akita11/SolenoidStrokeMeasureControl/work/test240513/graph.jpg

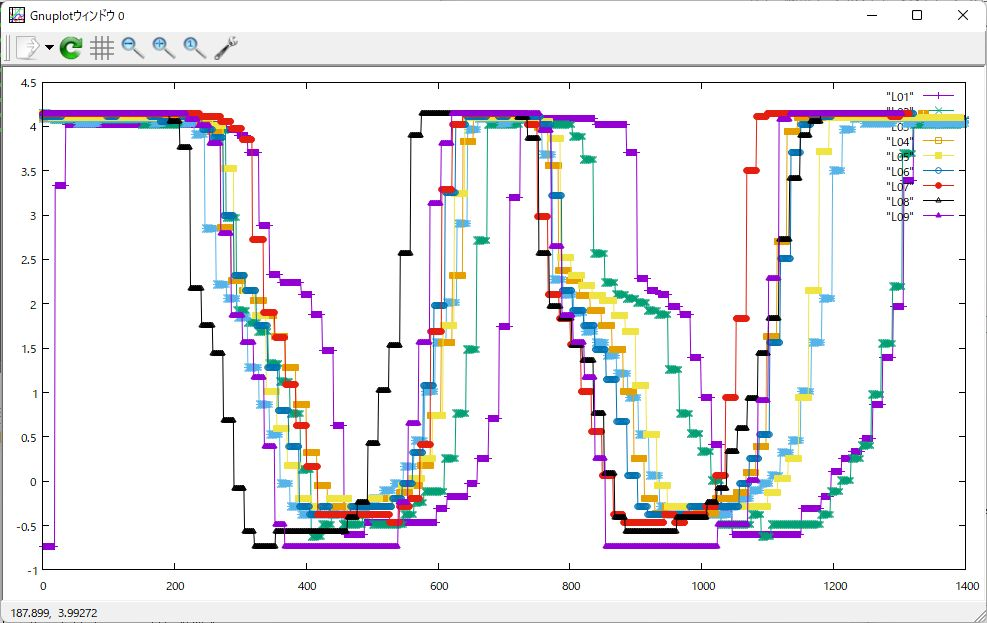
work/test240513/graph.jpg
