akita11/SolenoidStrokeMeasureControl/work/ESP32_Standalone/README.md

M5.update()などでけっこうADCのタイミングがばらつく。マルチコアをうまく使えば解消できるかもしれないが、現時点では十分に解消できていないので、いったん保留(240720:akita11)
