akita11/SolenoidStrokeMeasureControl/work/LTspice/Tlong_I.png

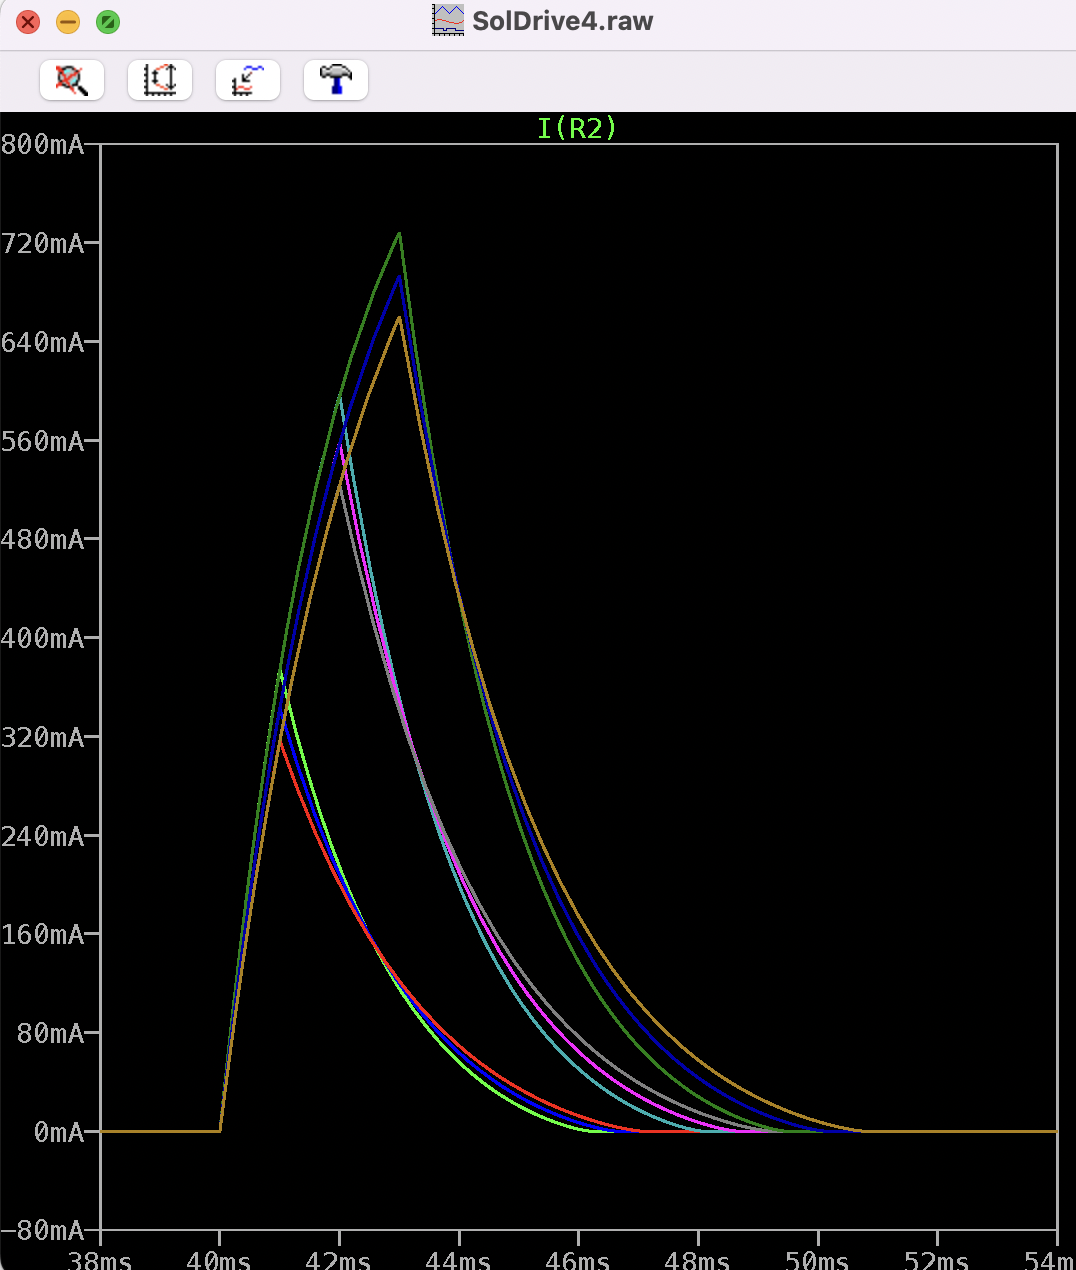
work/LTspice/Tlong_I.png
