akita11/SolenoidStrokeMeasureControl/work/LTspice/Tlong_V.png

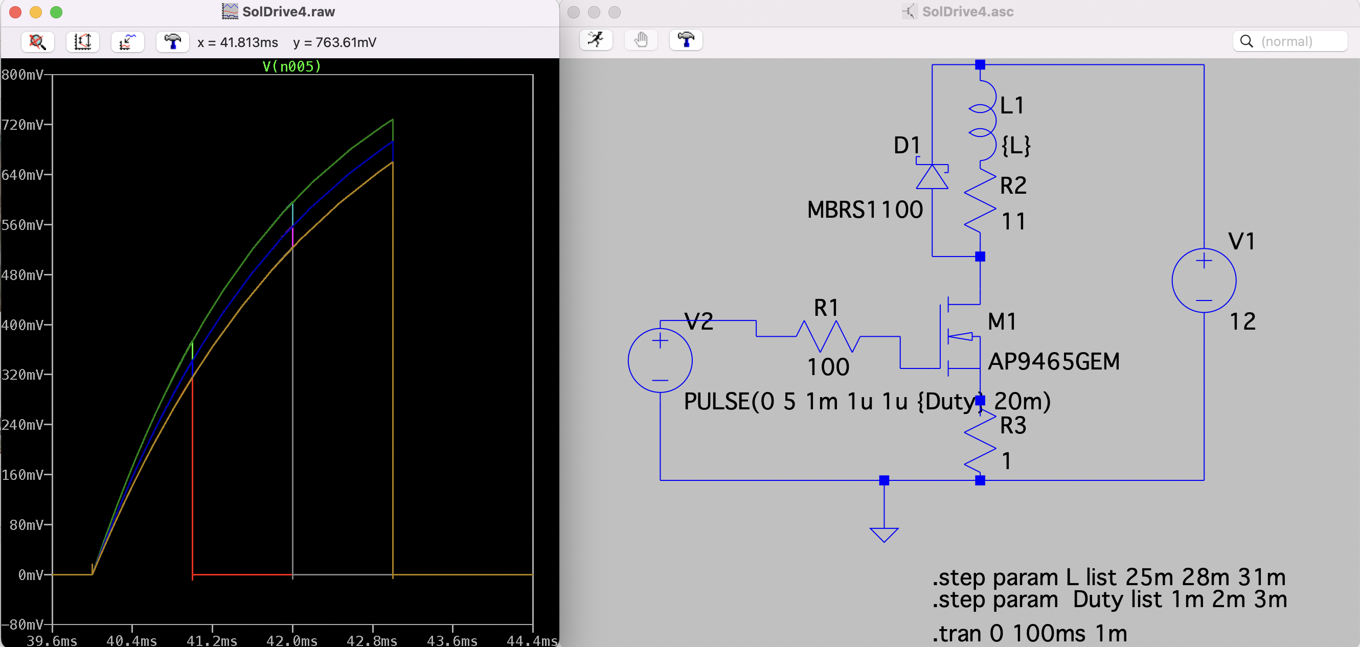
work/LTspice/Tlong_V.png
