akita11/SolenoidStrokeMeasureControl/work/LTspice/Tlong_V_IdealD.png

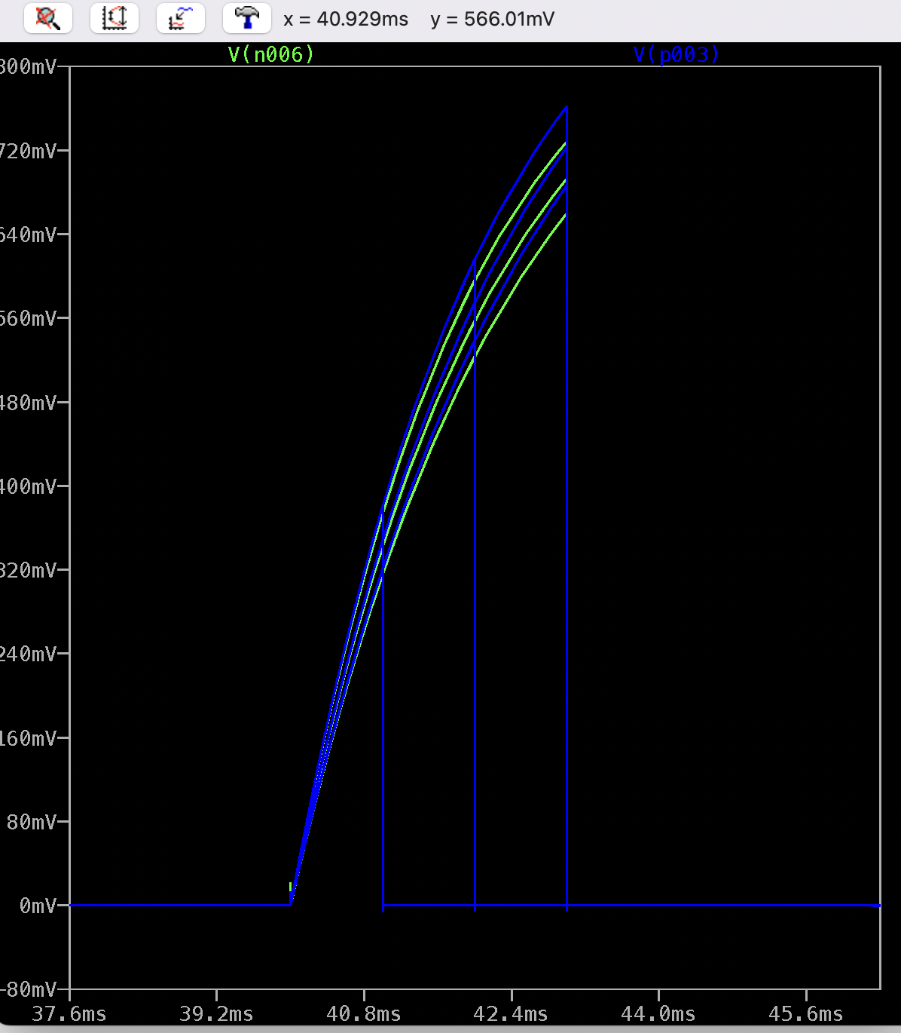
work/LTspice/Tlong_V_IdealD.png
