akita11/SolenoidStrokeMeasureControl/work/LTspice/Tshort_I.png

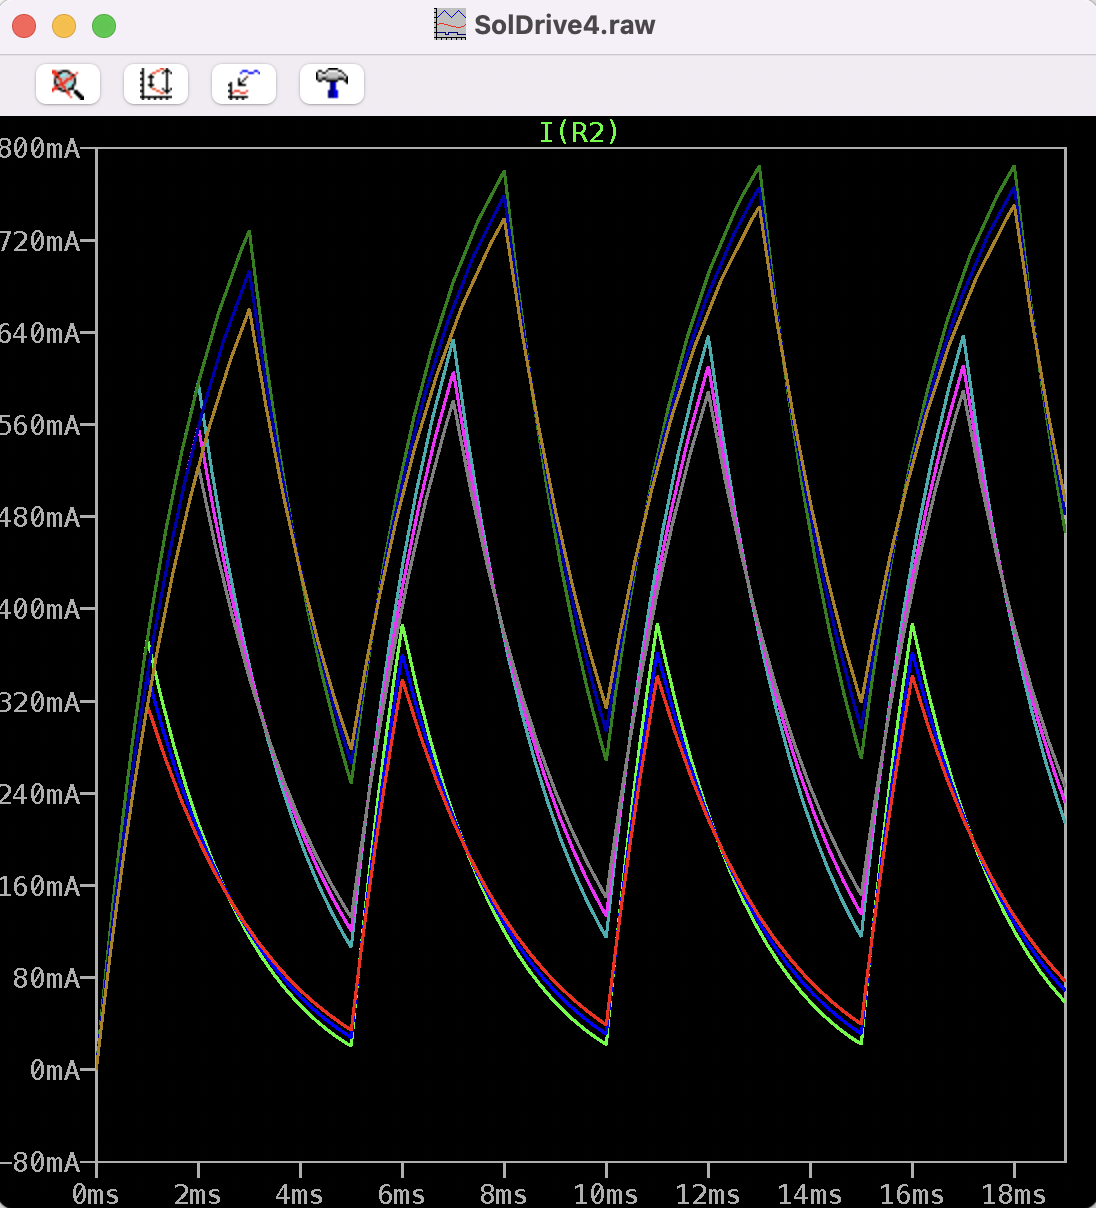
work/LTspice/Tshort_I.png
