akita11/SolenoidStrokeMeasureControl/work/LTspice/Tshort_V.png

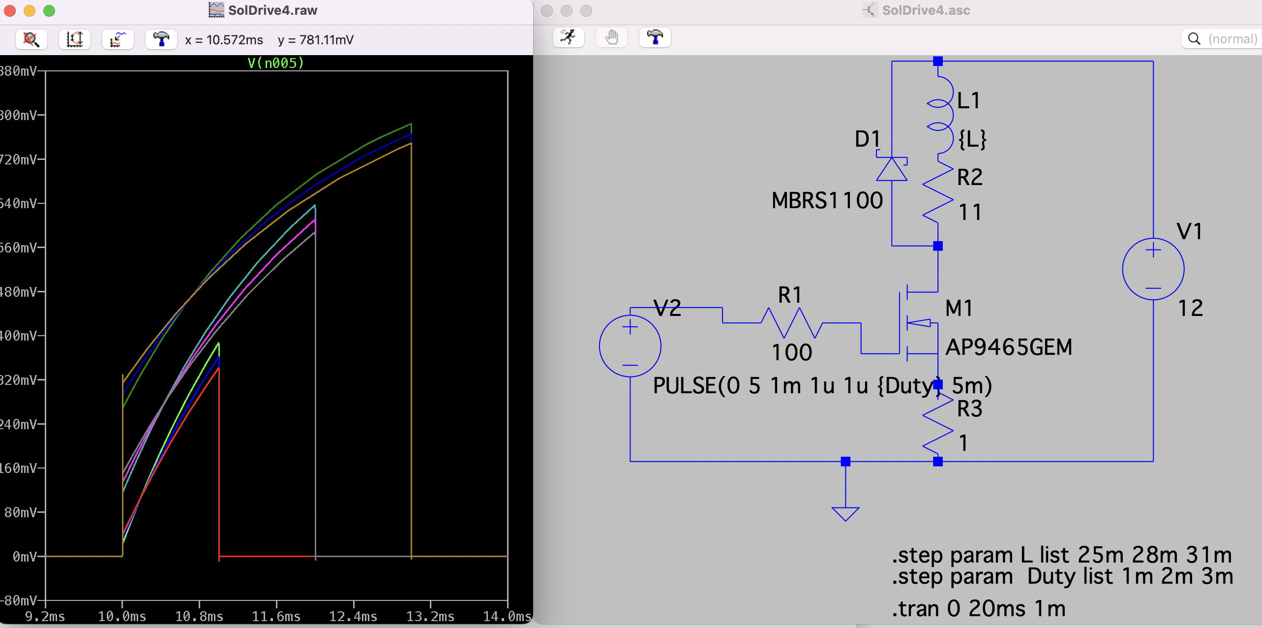
work/LTspice/Tshort_V.png
