akita11/SolenoidStrokeMeasureControl/work/LTspice/Tshort_V_IdealD.png

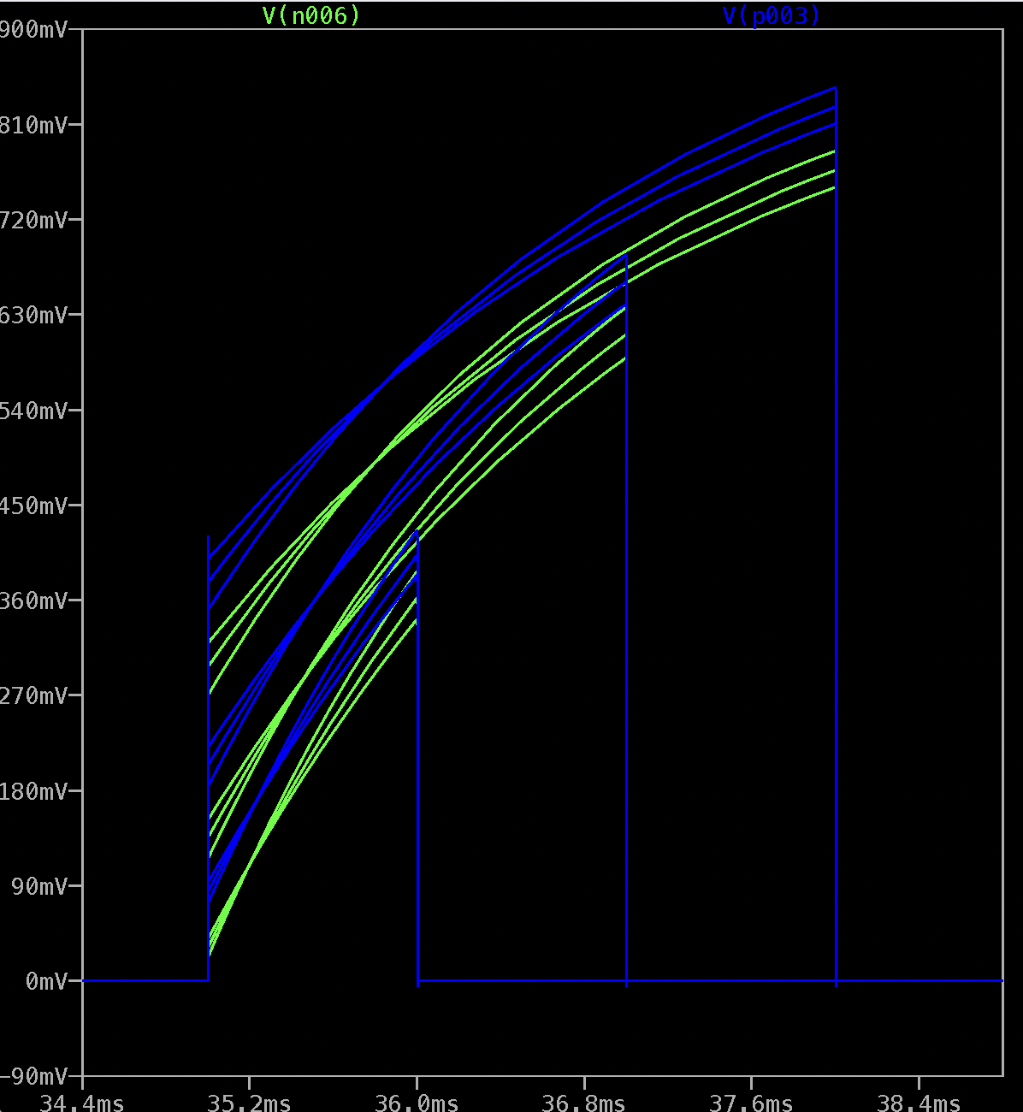
work/LTspice/Tshort_V_IdealD.png
