akita11/SolenoidStrokeMeasureControl/work/LTspice/V_0.png

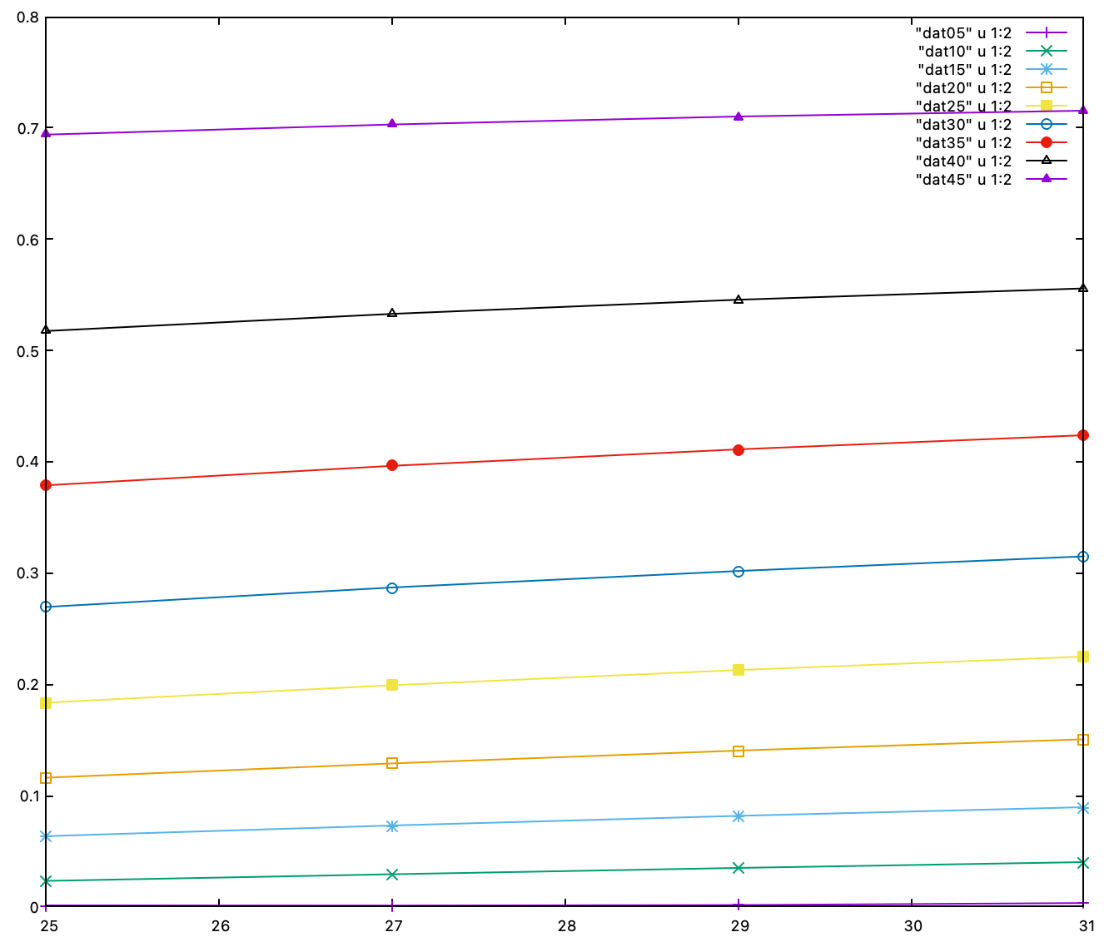
work/LTspice/V_0.png
