akita11/SolenoidStrokeMeasureControl/work/LTspice/V_05-0.png

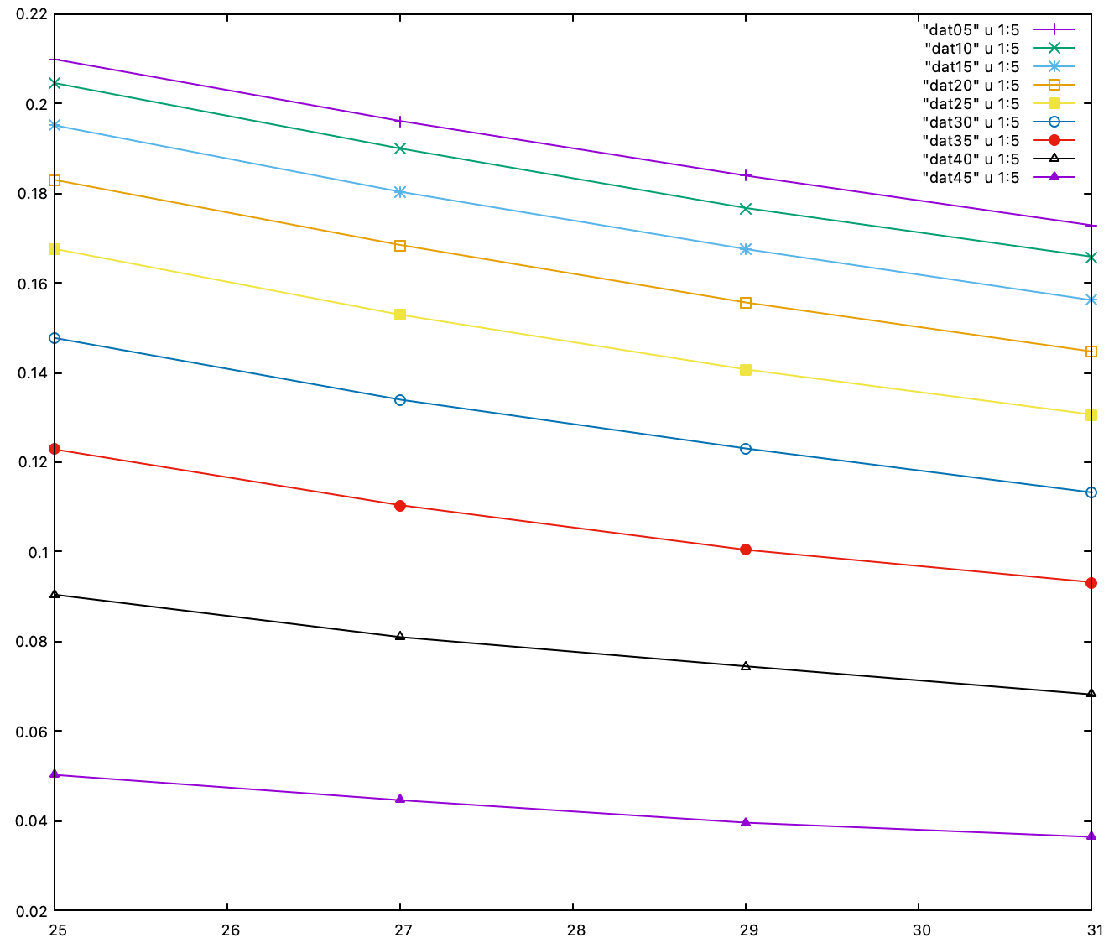
work/LTspice/V_05-0.png
