akita11/SolenoidStrokeMeasureControl/work/LTspice/V_05.png

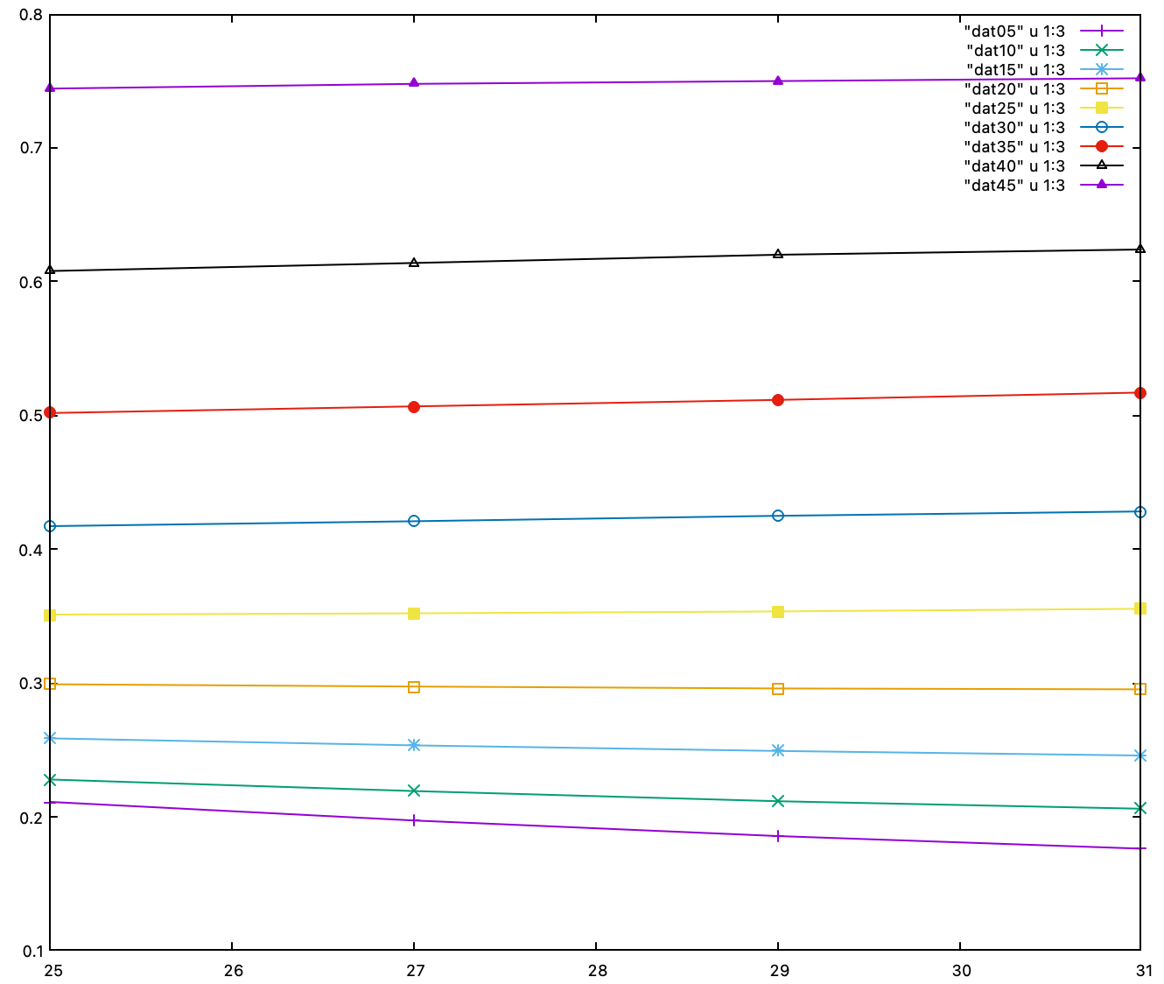
work/LTspice/V_05.png
