akita11/SolenoidStrokeMeasureControl/work/LTspice/V_10-05.png

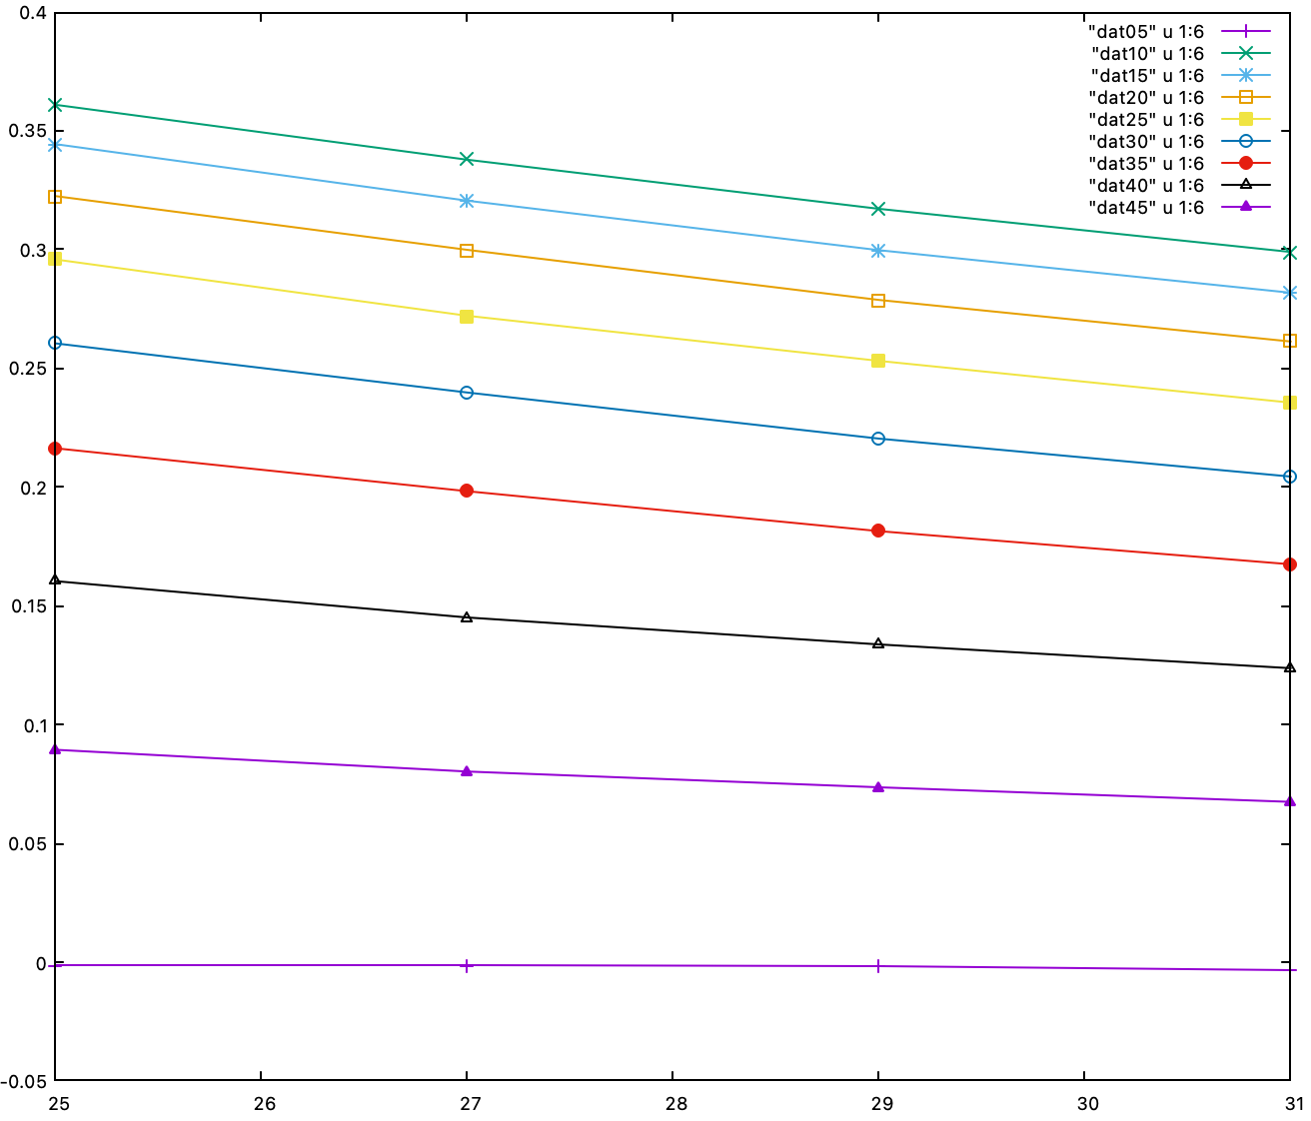
work/LTspice/V_10-05.png
