akita11/SolenoidStrokeMeasureControl/work/LTspice/V_10.png

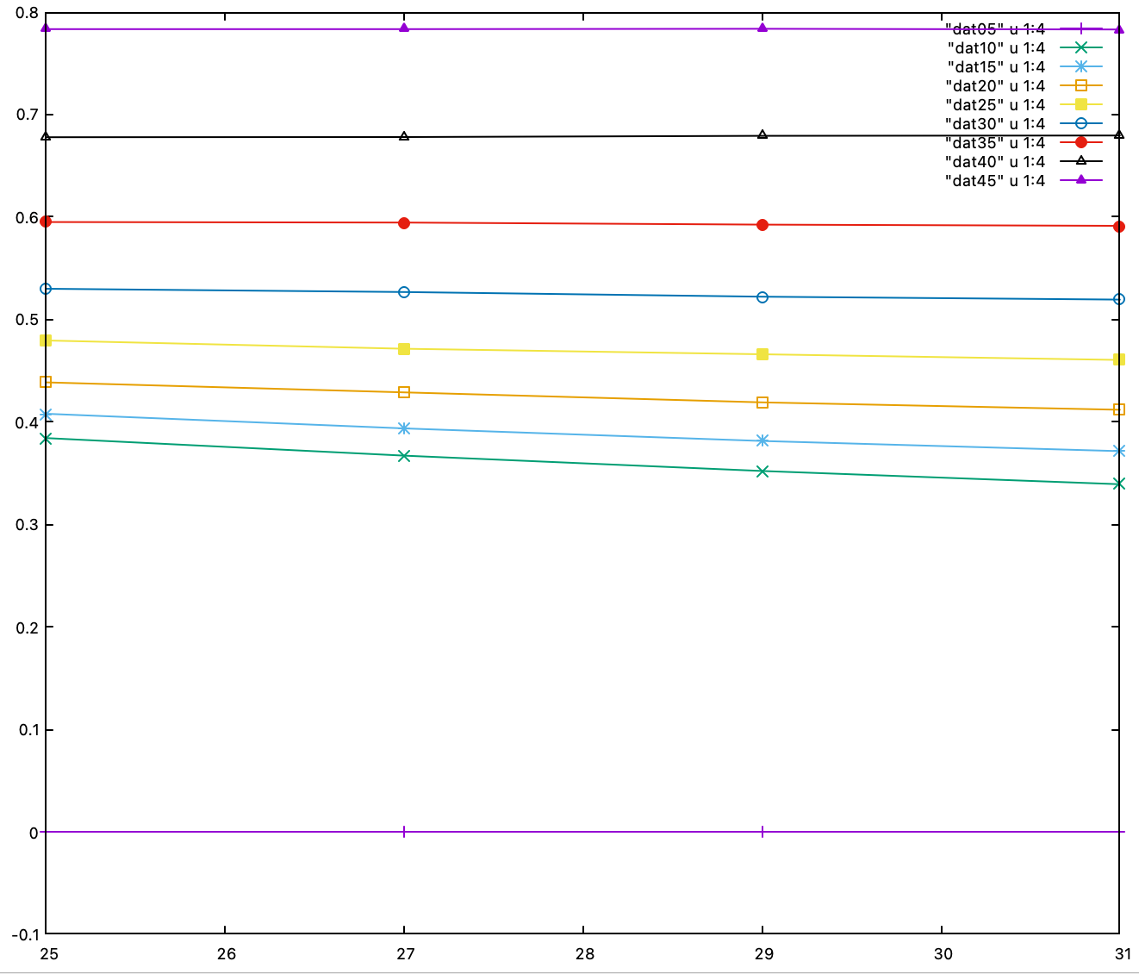
work/LTspice/V_10.png
