akita11/SolenoidStrokeMeasureControl/work/Measure_vs_Calc/SolStrokeExp.xlsx

Sheet: 240508
Rs= | 65.8
PWM Cycle=10ms
 |  |  | ADC[10bit] |  |  | V[V] |  |  | I(=V/Rs)[A]
Stroke | L[mH] | PWM ON[ms] | 50us | 100us | 500us | 50us | 100us | 500us | 50us | 100us | 500us | Ton | 500us-50us | 500us-100us
Neutral | 20.48 | 1 | 150 | 179 | 327 | 0.732421875 | 0.8740234375 | 1.596679688 | 0.03625850866 | 0.043268487 | 0.07904354889 | 1 | 0.04278504022 | 0.03577506188
Neutral | 20.48 | 2 | 148 | 176 | 324 | 0.72265625 | 0.859375 | 1.58203125 | 0.03577506188 | 0.04254331683 | 0.07831837871 | 2 | 0.04254331683 | 0.03577506188
Neutral | 20.48 | 3 | 147 | 175 | 321 | 0.7177734375 | 0.8544921875 | 1.567382812 | 0.03553333849 | 0.04230159344 | 0.07759320854 | 3 | 0.04205987005 | 0.0352916151
Neutral | 20.48 | 4 | 147 | 175 | 319 | 0.7177734375 | 0.8544921875 | 1.557617188 | 0.03553333849 | 0.04230159344 | 0.07710976176 | 4 | 0.04157642327 | 0.03480816832
Neutral | 20.48 | 5 | 149 | 177 | 320 | 0.7275390625 | 0.8642578125 | 1.5625 | 0.03601678527 | 0.04278504022 | 0.07735148515 | 5 | 0.04133469988 | 0.03456644493
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
