akita11/SolenoidStrokeMeasureControl/work/LTspice/IdealD.asc

D1: schottky; MBRS1100
D2: diode; Dideal
V1: voltage; 0
Named nets: 0
.dc v1 0 2 0.01
.model Dideal D(Ron=0.009 Roff=1MEG Vfwd=0.8 epsilon=1m revepsilon =1m)
