akita11/SolenoidStrokeMeasureControl/work/LTspice/SolDrive.asc

D1: schottky; MBRS1100
L1: ind; {L}; Rser=1
M1: nmos; AP9465GEM
R1: Res; 100
R2: Res; 10
V1: voltage; 12
V2: voltage; PULSE(0 5 0.5m 1u 1u 5m 10m)
Named nets: 0
.tran 0 50ms 1m
.step param L list 10m 12m 15m
