akita11/SolenoidStrokeMeasureControl/work/LTspice/SolDrive2.asc

D1: schottky; MBRS1100
L1: ind; {L}; Rser=1
M1: nmos; AP9465GEM
R1: Res; 100
R2: Res; 11
V1: voltage; 12
V2: voltage; PULSE(0 5 1m 1u 1u 50m 100m)
Named nets: 0
.tran 0 200ms 1m
.step param L list 25m 28m 31m
