akita11/SolenoidStrokeMeasureControl/work/LTspice/SolDrive4.asc

D1: schottky; MBRS1100
L1: ind; {L}; Rser=1
M1: nmos; AP9465GEM
R1: Res; 100
R2: Res; 11
R3: Res; 1
V1: voltage; 12
V2: voltage; PULSE(0 5 1m 1u 1u {Duty} 20m)
Named nets: 0
.tran 0 100ms 1m
.step param L list 25m 28m 31m
.step param  Duty list 1m 2m 3m
