akita11/SolenoidStrokeMeasureControl/work/LTspice/SolDrive_IdealD.asc

D1: schottky; MBRS1100
D2: diode; Dideal
L1: ind; {L}; Rser=1
L2: Ind; {L}
M1: nmos; AP9465GEM
M2: nmos; AP9465GEM
R1: Res; 100
R2: Res; 11
R3: Res; 1
R4: Res; 11
R5: Res; 1
V1: voltage; 12
V2: voltage; PULSE(0 5 1m 1u 1u {Duty} 5m)
Named nets: 0
.tran 0 100ms 1m
.step param L list 25m 28m 31m
.step param  Duty list 1m 2m 3m
.model Dideal D(Ron=0.01 Roff=1MEG Vfwd=0.7 epsilon=1m revepsilon =1m)
