akita11/SolenoidStrokeMeasureControl/work/LTspice/SolDrive_IdealD_fitting.asc

D1: schottky; MBRS1100
D2: diode; Dideal
L1: ind; 25m; Rser=1
L2: Ind; 25m
M1: nmos; AP9465GEM
M2: nmos; AP9465GEM
R1: Res; 100
R2: Res; 11
R3: Res; 1
R4: Res; 11
R5: Res; 1
V1: voltage; 12
V2: voltage; PULSE(0 5 1m 1u 1u 3m 5m)
Named nets: 0
.tran 0 100ms 1m
.model Dideal D(Ron={Ron} Roff=1MEG Vfwd={Vf} epsilon=1m revepsilon =1m)
.step param Vf list 0.5 1 1.5
.step param Ron list 0.001 0.01 0.1
