akita11/SolenoidStrokeMeasureControl/PCB/SolenoidStrokeMeasureControl_UNIT.kicad_pcb

## KiCad design PCB/SolenoidStrokeMeasureControl_UNIT.kicad_pcb (2024-04-24, last stored version)

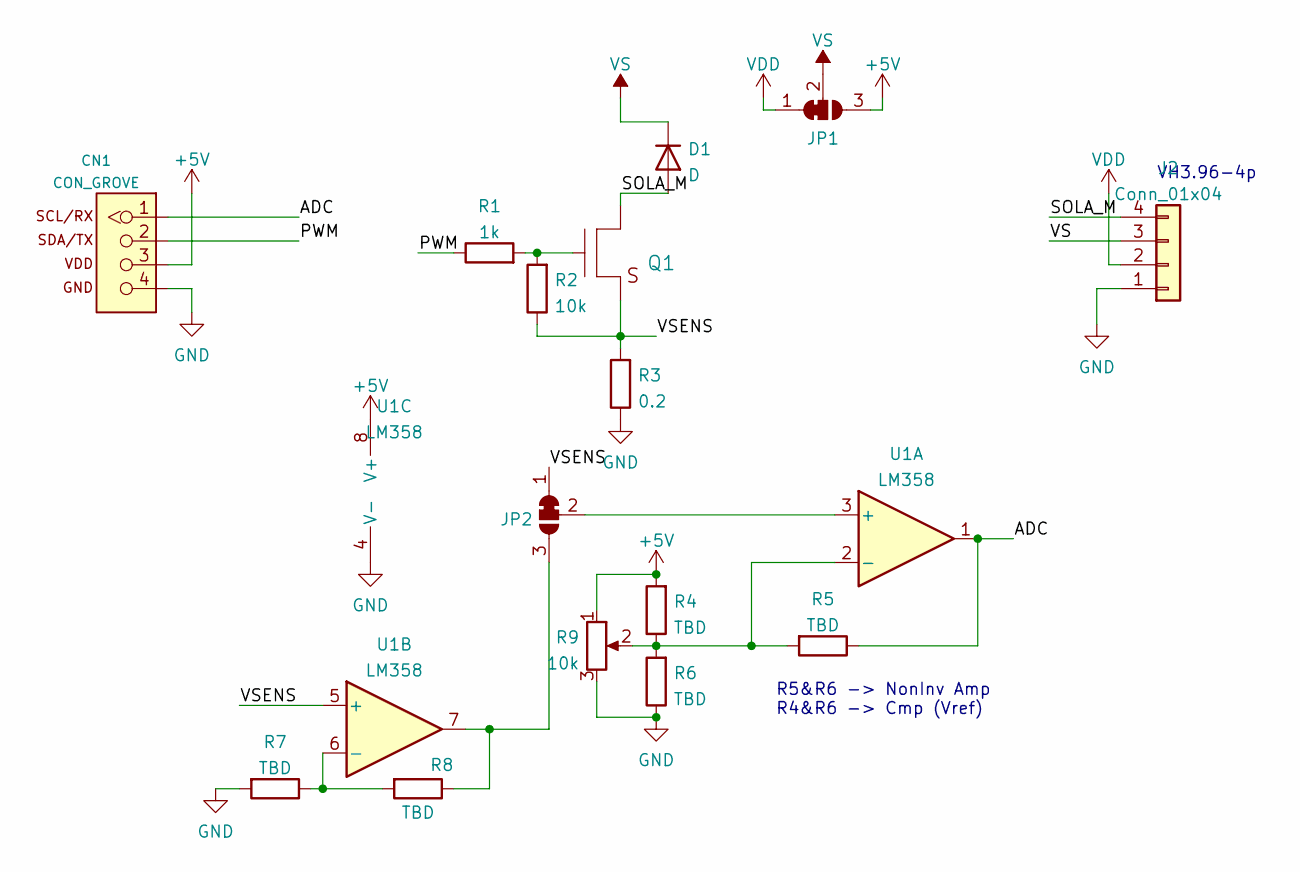
[picture p13: schematic SolenoidStrokeMeasureControl_UNIT.kicad_sch]

Parts:
CN1: CON_GROVE; CON_GROVE_H
D1: D; D_SOD-123F
J2: Conn_01x04; JST_VH_S4P-VH_1x04_P3.96mm_Horizontal
JP1, JP2: SolderJumper_3_Bridged12; SolderJumper-3_P1.3mm_Bridged2Bar12_Pad1.0x1.5mm
Q1: TR_NMOS_IRLML6344; SOT-23
R1: 1k; R_0603_1608Metric
R2: 10k; R_0603_1608Metric
R3: 0.2; R_1206_3216Metric
R4, R5, R6, R7, R8: TBD; R_0603_1608Metric
R9: 10k; Potentiometer_Bourns_3223W
U1: LM358; SO-8_5.3x6.2mm_P1.27mm

Connections:
+5V: CN1.3, JP1.3 (B), R4.2, R9.1, U1.8 (V+)
/ADC: CN1.1, R5.1, U1.1
/PWM: CN1.2, R1.1
/SOLA_M: D1.2 (A), J2.4, Q1.3 (D)
/VSENS: JP2.1 (A), Q1.2 (S), R2.1, R3.2, U1.5 (+)
GND: CN1.4, J2.1, R3.1, R6.1, R7.2, R9.3, U1.4 (V-)
unnamed: JP2.2 (C), U1.3 (+)
unnamed: JP2.3 (B), R8.1, U1.7
unnamed: Q1.1 (G), R1.2, R2.2
unnamed: R4.1, R5.2, R6.2, R9.2, U1.2 (-)
unnamed: R7.1, R8.2, U1.6 (-)
VDD: J2.2, JP1.1 (A)
VS: D1.1 (K), J2.3, JP1.2 (C)

Notes on the sheet:
R5&R6 -> NonInv Amp R4&R6 -> Cmp (Vref)
VH3.96-4p

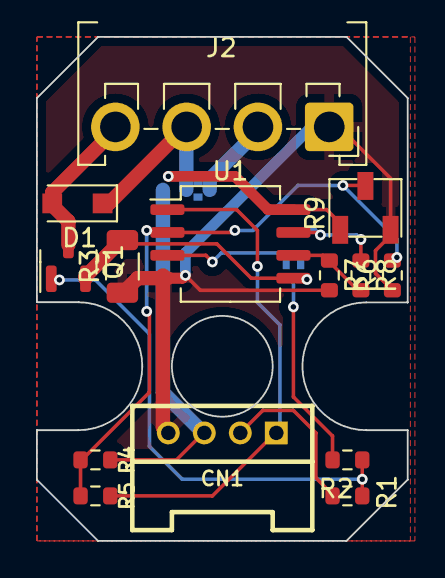
[picture p14: board SolenoidStrokeMeasureControl_UNIT.kicad_pcb from above]

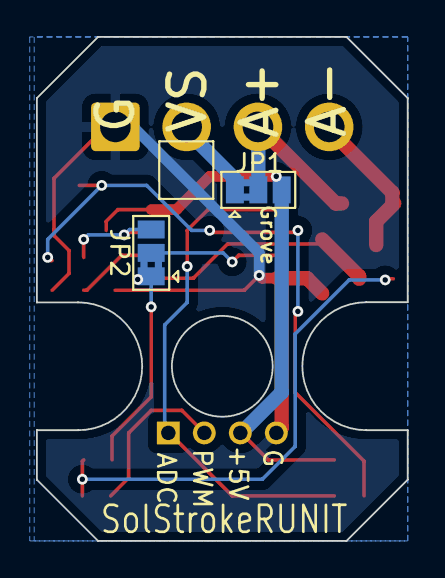
[picture p15: board SolenoidStrokeMeasureControl_UNIT.kicad_pcb from below]

Board: 2 copper layers, 20.6 x 28.0 mm, 16 parts (2 on the bottom side), 13 nets.
