akita11/SolenoidStrokeMeasureControl/Control_ESP32/src/main.cpp

// Solenoid Stroke Measure & Control using CNN
// (c) 2024 Junichi Akita (@akita11, akita@ifdl.jp)
// running TensorFlowLite on ESP32/ESP32-S3
// based on Chirale-TensorFlowLite's example, hello_world
// using M5Stack Core2/S3SE　with library: https://github.com/spaziochirale/Chirale_TensorFlowLite
//
// Copyright 2024 Chirale, TensorFlow Authors. All Rights Reserved.
// Licensed under the Apache License, Version 2.0;

//#define MEASURE_TEMP // measure temp using KmeterISO UNIT

#include <M5Unified.h>
#include "SliderUI.h"
#ifdef MEASURE_TEMP
#include <M5_KMeter.h>
M5_KMeter sensor;
#endif

#include <Chirale_TensorFlowLite.h>

#include "tensorflow/lite/micro/all_ops_resolver.h"
#include "tensorflow/lite/micro/micro_interpreter.h"
#include "tensorflow/lite/schema/schema_generated.h"

// generated model file
//#include "model-CH1284123-100-epoch1000.h" // Vs=12V, Rf=19.4k	
//#include "model-CBS0730140100-epoch10000.h" // Vs=6V, Rf=38k
//#include "model-CB10370380-100-epoch1000.h" // Vs=12V, Rf=38k	
//#include "model-SSBH-0830-100-epoch1000.h" // Vs=5V, Rf=19.4k
#include "model-SSBH.h" // for SSBH-0830-02, PWM=200Hz, SolStrokeUnit (Rf=19.4kHz), Vs=5.0V

// set PWM manually, and measure position. No control
//#define TEST

const tflite::Model* model = nullptr;
tflite::MicroInterpreter* interpreter = nullptr;
TfLiteTensor* input = nullptr;
TfLiteTensor* output = nullptr;

constexpr int kTensorArenaSize = 4000;
uint8_t tensor_arena[kTensorArenaSize];

#if defined(ARDUINO_M5STACK_CORE2)
// for Core2
// for PortA
#define PIN_TXD 33
#define PIN_RXD 32
#define PIN_SDA 14
#define PIN_SCL 13

#elif defined(ARDUINO_M5STACK_CORES3)
// for CoreS3SE
// for PortA
#define PIN_TXD 1
#define PIN_RXD 2
#define PIN_FLAG1 6
// for Port C
#define PIN_SDA 17
#define PIN_SCL 18
//USBCDC USBSerial;

#else
#error "No pin definition for this board"
#endif

uint16_t v0, v1;
#ifdef TEST
uint16_t Ton = 500; // initial PWM duty for debugging
#else
uint16_t Ton = 5000;
#endif
float pos_t = 1.0;
float Kp = 9.0;
#define BUF_LEN 64
char buf[BUF_LEN];
uint8_t pBuf = 0;
uint8_t fValid = 0;

typedef struct solenoid{
  float pos;
  float temp;
} Solenoid;

Solenoid sol;

static constexpr std::size_t slider_count = 2;
static slider_t slider_list[slider_count];

Solenoid predict(float Ton, float v0, float v1)
{
	Solenoid s;
	input->data.f[0] = (Ton - scaler_i_mean[0]) / scaler_i_scale[0];
	input->data.f[1] = (v0	- scaler_i_mean[1]) / scaler_i_scale[1];
	input->data.f[2] = (v1	- scaler_i_mean[2]) / scaler_i_scale[2];
	// Run inference, and report if an error occurs
	TfLiteStatus invoke_status = interpreter->Invoke();
	if (invoke_status != kTfLiteOk) {
		printf("Invoke failed!\n");
		while(1);
	}
	s.pos  = output->data.f[0] * scaler_o_scale[0] + scaler_o_mean[0];
	s.temp = output->data.f[1] * scaler_o_scale[1] + scaler_o_mean[1];

	return(s);
}

/*
// ref: https://moons.link/esp32/post-769/
volatile SemaphoreHandle_t uartSemaphore;
TaskHandle_t taskHandle[2];
void uart_task(void *args){
	while(1){
	}
}

void CreateTasks(void *args) {
	xTaskCreatePinnedToCore(uart_task, "uart_task", 4096, uartSemaphore, 2, &taskHandle[0], APP_CPU_NUM);
	while(1);
}
*/

uint32_t tm0;

uint16_t xt, xt0;
uint16_t pt, pt0;
volatile uint8_t fTouched = 0;
#ifdef TEST_ALL
volatile uint8_t fRun = 0;
uint16_t ns = 0;
uint8_t iTon = 0;
uint8_t iToni[] = {1, 9, 2, 8, 3, 7, 4, 6, 5};
#else
volatile uint8_t fRun = 1;
#endif

void setup() {
	M5.begin();

	Serial2.begin(115200, SERIAL_8N1, PIN_RXD, PIN_TXD);
	Serial.begin(115200);

#ifdef MEASURE_TEMP
  Wire.begin(PIN_SDA, PIN_SCL, 400000L); // SDA/SCL, for PortC (CoreS3)
	sensor.begin(&Wire, 0x66);
#endif

	pinMode(PIN_FLAG1, OUTPUT);

	M5.Display.setTextSize(2);

#ifdef TEST
	// slider for PWM
	slider_list[0].setup({0, 180, 320, 60}, 5,	100,	10, TFT_WHITE, TFT_BLACK, TFT_LIGHTGRAY);
#else
	// slider for St
	slider_list[0].setup({0, 180, 320, 60}, 0,	500,	100, TFT_WHITE, TFT_BLACK, TFT_LIGHTGRAY);

	// slider for Kp
	slider_list[1].setup({0, 0, 320, 40}, 0,	1000,	(int)(Kp*100), TFT_RED, TFT_BLACK, TFT_RED);
#endif

	M5.Display.setEpdMode(epd_mode_t::epd_fastest);
	for (std::size_t i = 0; i < slider_count; ++i) slider_list[i].draw();

	// ------------------------------
	// Setup TensorFlow Lite
	// ------------------------------
	// Map the model into a usable data structure. This doesn't involve any
	// copying or parsing, it's a very lightweight operation.
	model = tflite::GetModel(g_model);

	// Check if model and library have compatible schema version,
	// if not, there is a misalignement between TensorFlow version used
	// to train and generate the TFLite model and the current version of library
	if (model->version() != TFLITE_SCHEMA_VERSION) {
		printf("Model provided and schema version are not equal!\n");
		while(true);
	}
	// This pulls in all the TensorFlow Lite operators.
	static tflite::AllOpsResolver resolver;
	// Build an interpreter to run the model with.
	static tflite::MicroInterpreter static_interpreter(model, resolver, tensor_arena, kTensorArenaSize);
	interpreter = &static_interpreter;

	// Allocate memory from the tensor_arena for the model's tensors.
	TfLiteStatus allocate_status = interpreter->AllocateTensors();
	if (allocate_status != kTfLiteOk) {
		printf("AllocateTensors() failed\n");
		while(true);
	}
	// Obtain pointers to the model's input and output tensors.
	input = interpreter->input(0);
	output = interpreter->output(0);

	delay(1000);
	Serial2.println("D6250");
	delay(100);
	Serial2.println("T6250"); // PWM cycle=500us(200Hz)
	delay(100);
	Serial2.println("062"); // t0=49.6us(200Hz)
	delay(100);
	Serial2.println("1432"); // t1=345.6us(200Hz)
	delay(100);
	Serial2.println("D1");
/*
	disableCore0WDT();
	uartSemaphore = xSemaphoreCreateBinary();
	// assign timer_task to Core 0 (PRO) (usually used for radio tasks)
//	xTaskCreateUniversal(uart_task, "task1", 8192, NULL, 2, NULL, PRO_CPU_NUM);
 	xSemaphoreGive(uartSemaphore);
	xTaskCreatePinnedToCore(CreateTasks, "CreateTasks", 4096, NULL, 2, &taskHandle[0], PRO_CPU_NUM);
*/
	Serial2.println("C1"); // PWM=100Hz -> every 10ms
	delay(1000);
	tm0 = millis();
	if (fRun == 1){
		M5.Display.fillRect(140, 100, 40, 40, TFT_GREEN);
		Serial2.println("S");
	}
	else{
		M5.Display.fillRect(140, 100, 40, 40, TFT_BLACK);
		M5.Display.drawRect(140, 100, 40, 40, TFT_WHITE);
	}
}

void loop() {
	M5.update();
	auto t = M5.Touch.getDetail();

#ifdef TEST
	if (slider_list[0].update(t)) {
		if (slider_list[0].wasChanged()){
			float duty = (float)(slider_list[0].getValue()) / 100;
			Serial2.printf("D%d\n", (uint16_t)(duty * 6250));
			Ton = (uint16_t)(duty * 5000); // Ton[us]
		}
	}
#else
	if (slider_list[0].update(t)) {
		if (slider_list[0].wasChanged()) pos_t = (float)(slider_list[0].getValue()) / 100;
	}
	if (slider_list[1].update(t)) {
		if (slider_list[1].wasChanged()){
			Kp = (float)(slider_list[1].getValue()) / 100;
			M5.Display.fillRect(0, 40, 320, 20, TFT_BLACK);
			M5.Display.setCursor(0, 40);
			M5.Display.setTextColor(TFT_RED, TFT_BLACK);
			M5.Display.printf("Kp:%.2f", Kp);
		}
	}
#endif
	int tx, ty;

	if (t.isPressed()){
		tx = t.x; ty = t.y;
		if (fTouched == 0){
			if (140 < tx && tx < 180 && 100 < ty && ty < 140){
				fTouched = 1;
				fRun = 1 - fRun;
				if (fRun == 1){
					Serial2.println("S");
#ifdef TEST
					Serial.println("START"); 
#endif
					M5.Display.fillRect(140, 100, 40, 40, TFT_GREEN);
					tm0 = millis();
					Serial2.printf("D%d\n", Ton); // set PWM
				}
				else{
					Serial2.println("P");
					M5.Display.fillRect(140, 100, 40, 40, TFT_BLACK);
					M5.Display.drawRect(140, 100, 40, 40, TFT_WHITE);
					Serial2.println("D1"); // PWM off (idle)
				}
				delay(500);
			}
		}
	}
	if (fTouched == 1 && t.isReleased()) fTouched = 0;

	if (Serial.available()){
		char c = Serial.read();
		if (c == '\n' || c == '\r'){
			buf[pBuf] = '\0';
			if (pBuf > 2){
				pos_t = atof(buf);
				printf("pos_t:%.3f\n", pos_t);
			}
			pBuf = 0;
		}
		else buf[pBuf++] = c;
		if (pBuf == BUF_LEN) pBuf = 0;	}

	if (Serial2.available()){
		char c = Serial2.read();
		if (c == '\n' || c == '\r'){
			buf[pBuf] = '\0';
			if (pBuf == 8){
				// 00001111
				v1 = atoi(buf + 4);
				buf[4] = '\0';
				v0 = atoi(buf);
				fValid = 1;
			}
			pBuf = 0;
		}
		else buf[pBuf++] = c;
		if (pBuf == BUF_LEN) pBuf = 0;
	}

	if (fValid == 1){
		// Position Measure
		digitalWrite(PIN_FLAG1, 1);
		sol = predict((float)Ton/1000.0, (float)v0, (float)v1); // 0.5ms
		digitalWrite(PIN_FLAG1, 0); // -1ms
//		if (sol.pos < 0) sol.pos = 0.0;
//		else if (sol.pos > 5.0) sol.pos = 5.0;
		xt = (uint16_t)((sol.pos / 5.0) * 319);
		M5.Display.drawFastVLine(xt0, 140, 40, TFT_BLACK);
		M5.Display.drawFastVLine(xt,	140, 40, TFT_GREEN);
		pt = (uint16_t)(Ton * 32 / 1000);
		M5.Display.drawFastVLine(pt0, 80, 20, TFT_BLACK);
		M5.Display.drawFastVLine(pt,	80, 20, TFT_CYAN);
		xt0 = xt; pt0 = pt;
		digitalWrite(PIN_FLAG1, 1); // 0.2us
#ifdef TEST
 #ifdef MEASURE_TEMP
		sensor.update();
		float temp = sensor.getTemperature();
 #else
		printf("%d %d %.3f %.3f %.3f\n", millis() - tm0, Ton, sol.pos, pos_t, sol.temp);
 #endif
#else
		// Position Control
		int16_t dTon = (uint16_t)((pos_t - sol.pos) * Kp);
		int16_t Ton_t = Ton + dTon;
 #define Ton_MAX 4950 // 4.95[ms] for 200Hz
 #define Ton_MIN  500 // 0.50[ms]for 200Hz
		if (Ton_t > Ton_MAX) Ton = Ton_MAX;
		else if (Ton_t < Ton_MIN) Ton = Ton_MIN;
		else Ton = Ton_t;
		float duty = (float)Ton / 5000.0;
		Serial2.printf("D%d\n", (uint16_t)(duty * 6250)); // set PWM
 #ifdef MEASURE_TEMP
		sensor.update();
		float temp = sensor.getTemperature();
		printf("%d %.3f %.3f %.3f %.3f\n", millis() - tm0, sol.pos, pos_t, sol.temp, temp);
 #else
		printf("%d %.3f %.3f %.3f\n", millis() - tm0, sol.pos, pos_t, sol.temp);
 #endif
#endif
		fValid = 0;
		digitalWrite(PIN_FLAG1, 0); // about 1.2ms in total
	}
}
