akita11/SolenoidStrokeMeasureControl/(commit log)

2024-04-25 add bom
2024-04-25 fix BOM typo
2024-05-02 add ADC acquire
2024-05-08 add Arduino measure code
2024-05-09 add sim&calc, exp results
    [SolStrokeExp.xlsx, deltaV.xlsx]
2024-05-09 add stroke-L measurement
    [SolenoidStroke-L.xlsx]
2024-05-13 add test for manual move
    [SolenoidStroke-L.xlsx]
2024-05-14 PID control
2024-05-25 MCPWM test for ESP32 measure
2024-05-27 separate measure&control, ESP32
2024-05-29 ESP32 control (draft)
2024-05-29 MCPWM interrupt test
2024-06-11 Measure&Control for ESP32
2024-06-13 ESP32 control x2
2024-06-14 slider color for LongStroke+ESP32
2024-06-19 update readme, delete pcb
    [SolenoidStrokeMeasureControl_UNIT.kicad_pcb, SolenoidStrokeMeasureControl_UNIT.kicad_sch]
2024-07-02 draw PWM graph
2024-07-05 periodic PWM control & log for RF
2024-07-10 measure at 100&200Hz
2024-07-13 bug fix on Measure_ESP32
    [main.cpp]
2024-07-17 Measure raw ADC
2024-07-19 separated ESP32 measure&control
2024-07-19 control NN with MeasCtrl ATOM-S3
    [SolStrokeExp.xlsx, deltaV.xlsx]
2024-07-19 summarize work
    [SolenoidStroke-L.xlsx]
2024-07-19 NN control for CBS0730140
    [学習用CBS0730140.xlsx]
2024-07-20 CNN models for 3 solenoids
    [SolPosMeas240719.xlsx, 学習用CBS0730140.xlsx]
2024-07-20 add CH1284 model
    [SolPosMeas240719.xlsx]
2024-07-22 Meas&Ctrl for Arduino
2024-07-23 controlNN pos_t by uart
2024-08-06 240806 measured model
    [SolPosMeas240719.xlsx, SolPosMeas240805.xlsx]
2024-09-15 working UART&PWM
2024-11-25 timerISR & UART command (partial)
2024-12-27 measure ESP32 for ATtiny UNIT
2025-01-25 add SSBH model for SolStrU
    [SolPosMeas250125.xlsx]
2025-01-26 control@200Hz using SolStrokeU
